jpwolfe31/14x63-Luminator-Flip-Dot-Display/Photos/glued dot pylon too.jpg

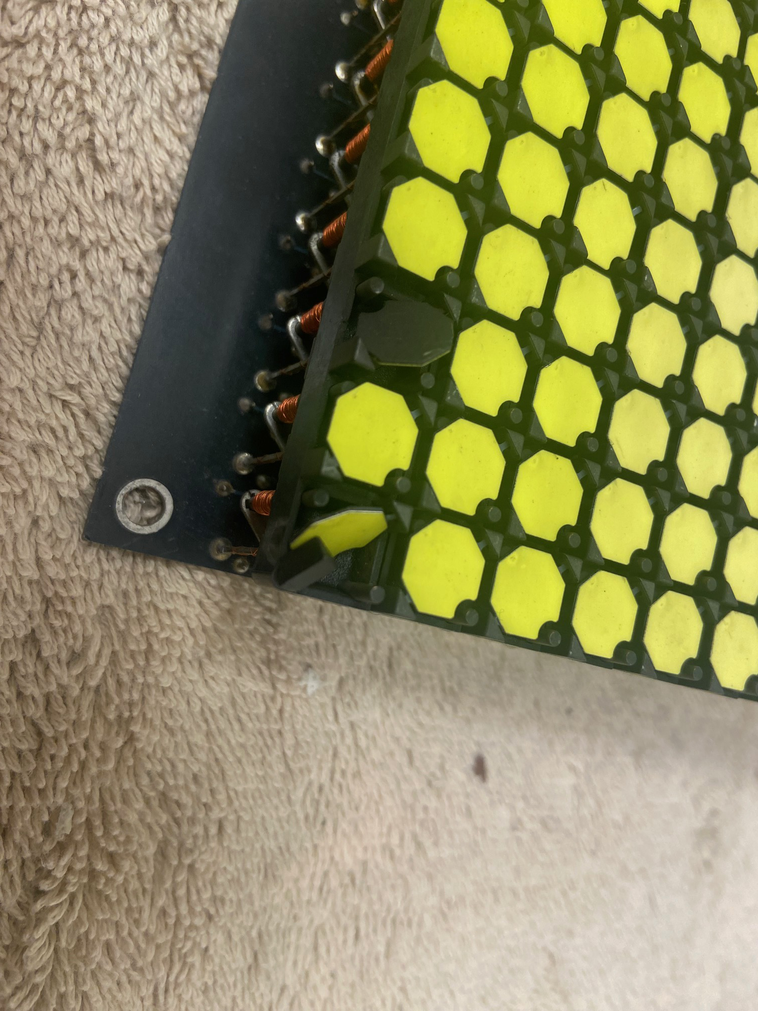
Photos/glued dot pylon too.jpg
