jpwolfe31/14x63-Luminator-Flip-Dot-Display/Photos/almost out of wire.jpg

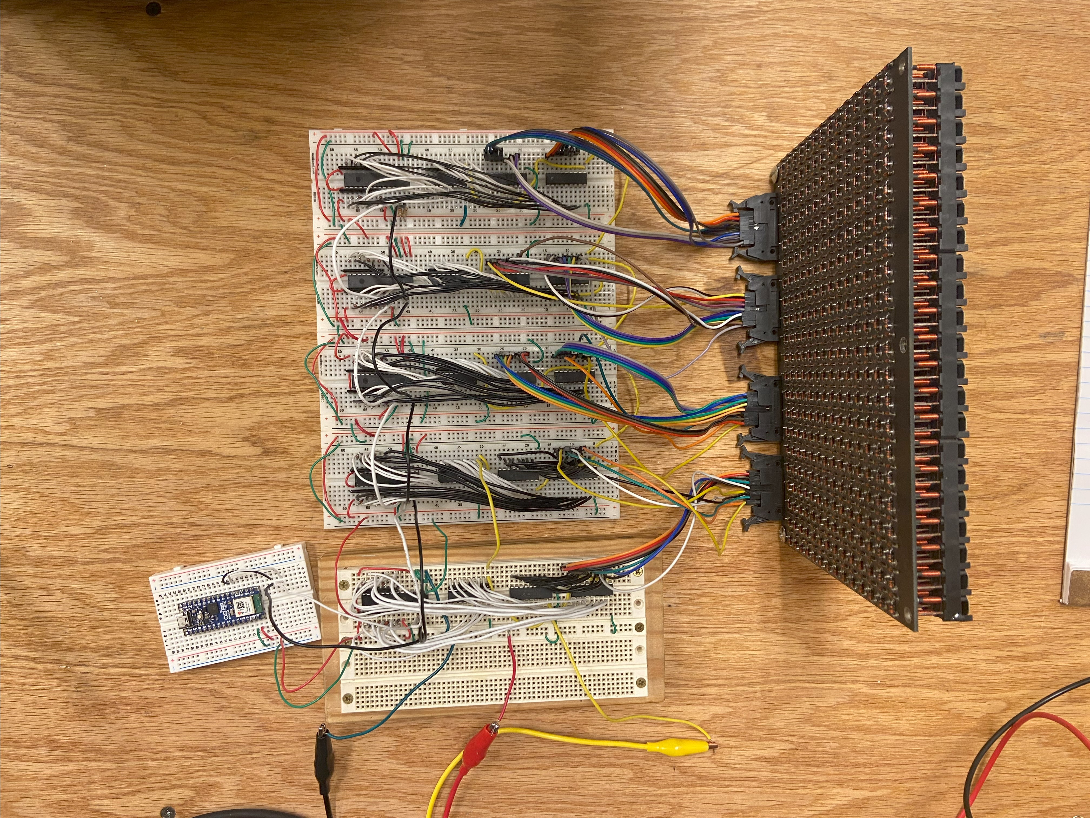
Photos/almost out of wire.jpg
