jpwolfe31/14x63-Luminator-Flip-Dot-Display/IMG_2127.JPG

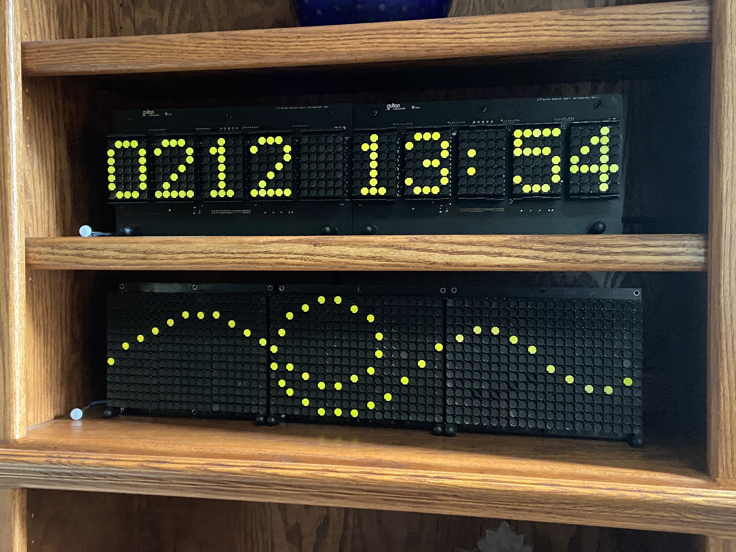
IMG_2127.JPG
