jpwolfe31/14x63-Luminator-Flip-Dot-Display/Photos/as delivered.jpg

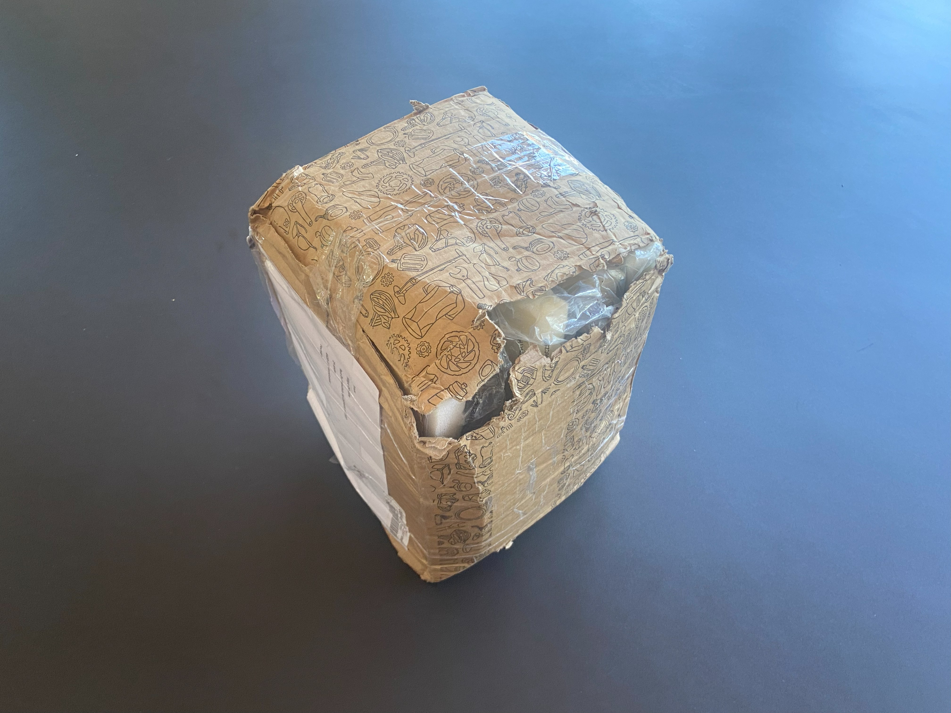
Photos/as delivered.jpg
