jpwolfe31/14x63-Luminator-Flip-Dot-Display/Photos/easily glued back.jpg

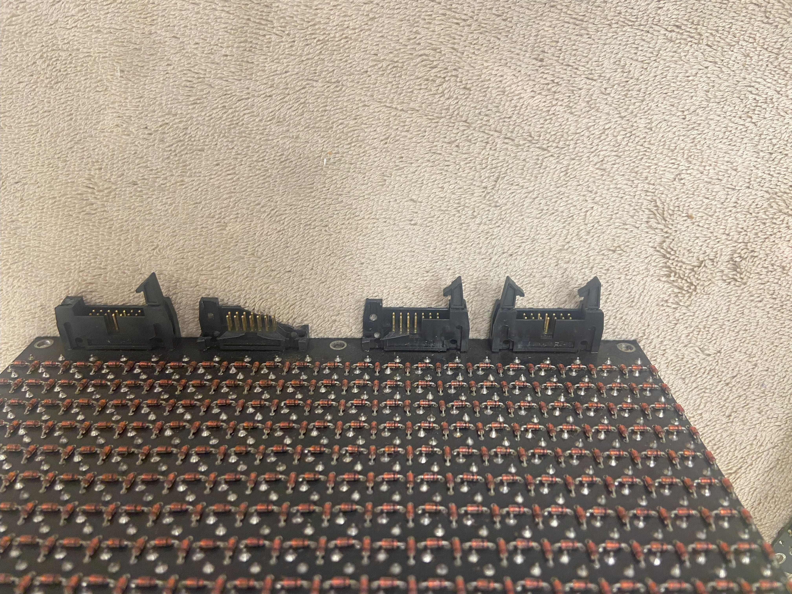
Photos/easily glued back.jpg
