jpwolfe31/14x63-Luminator-Flip-Dot-Display/14-63 Flip Dot PDF Schematic 2-12-25.pdf

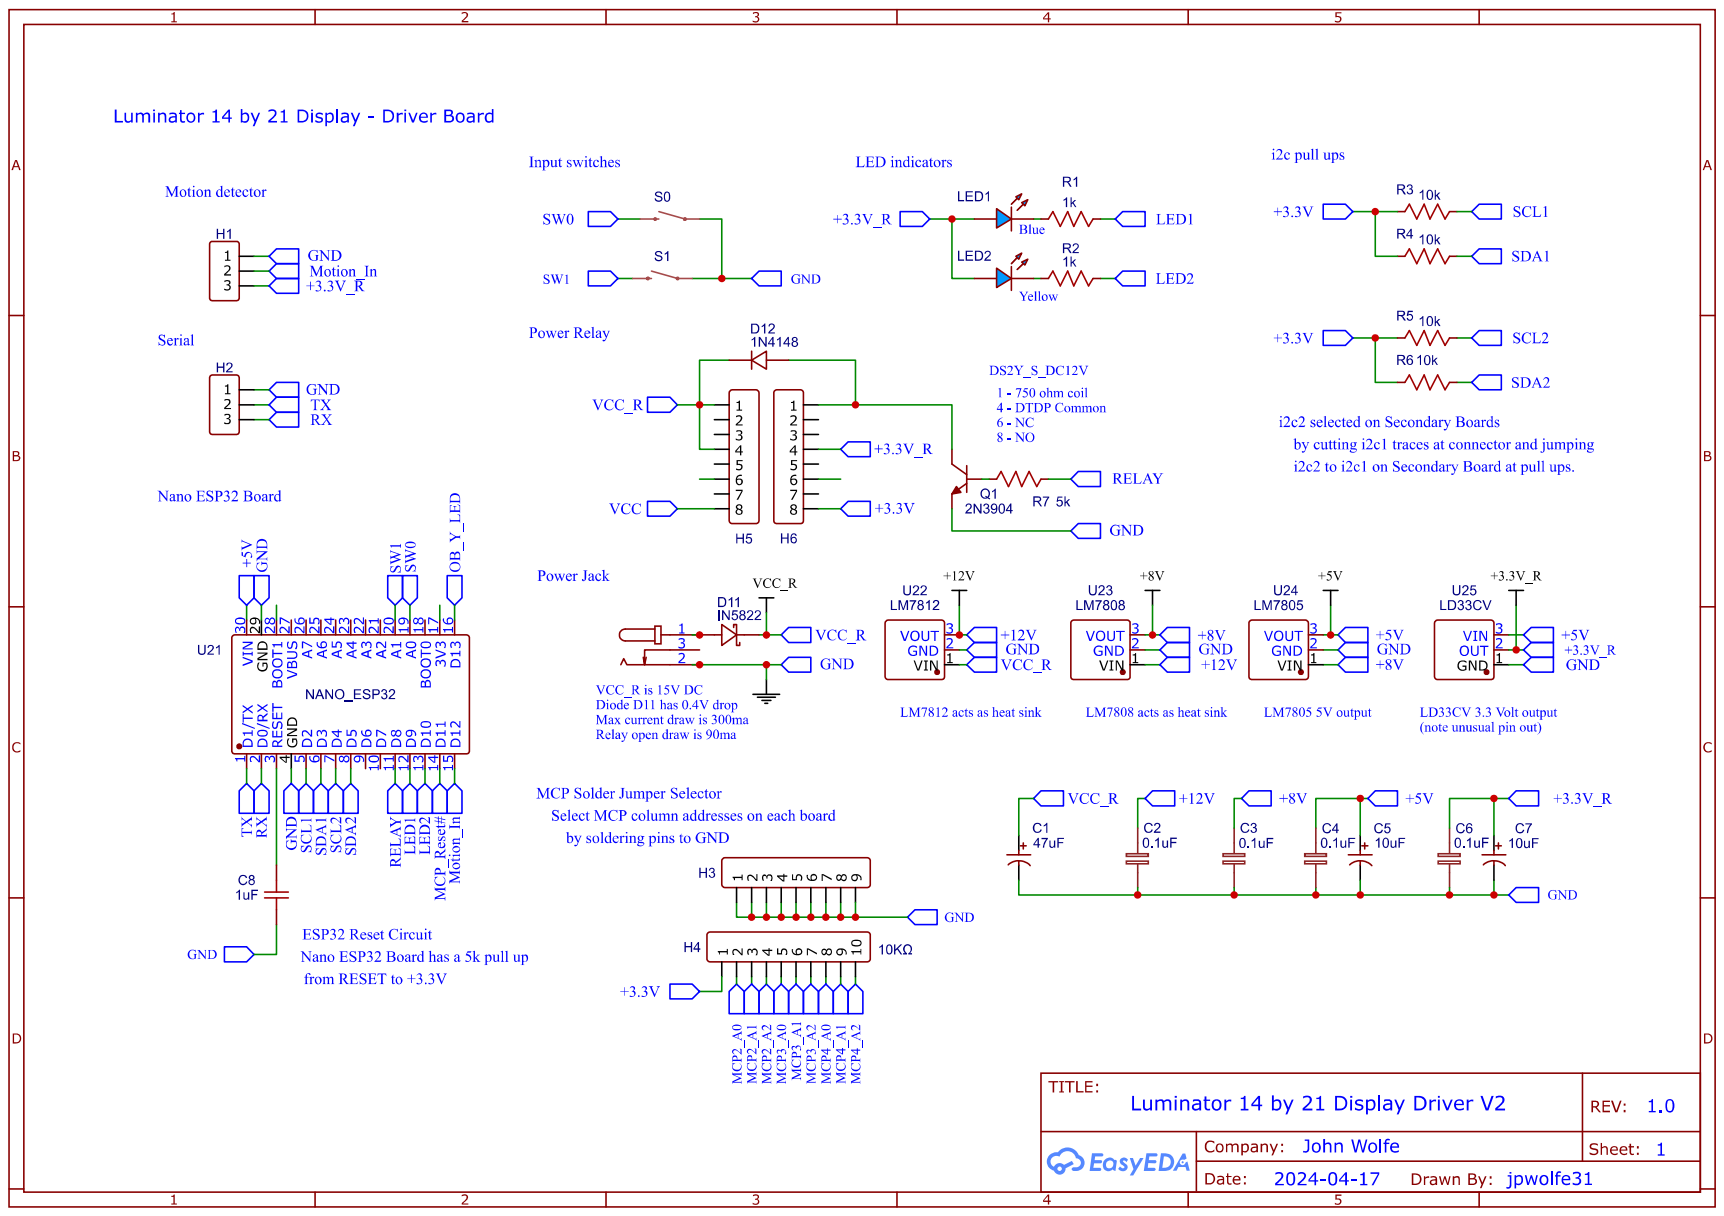
[picture p15: page 1]

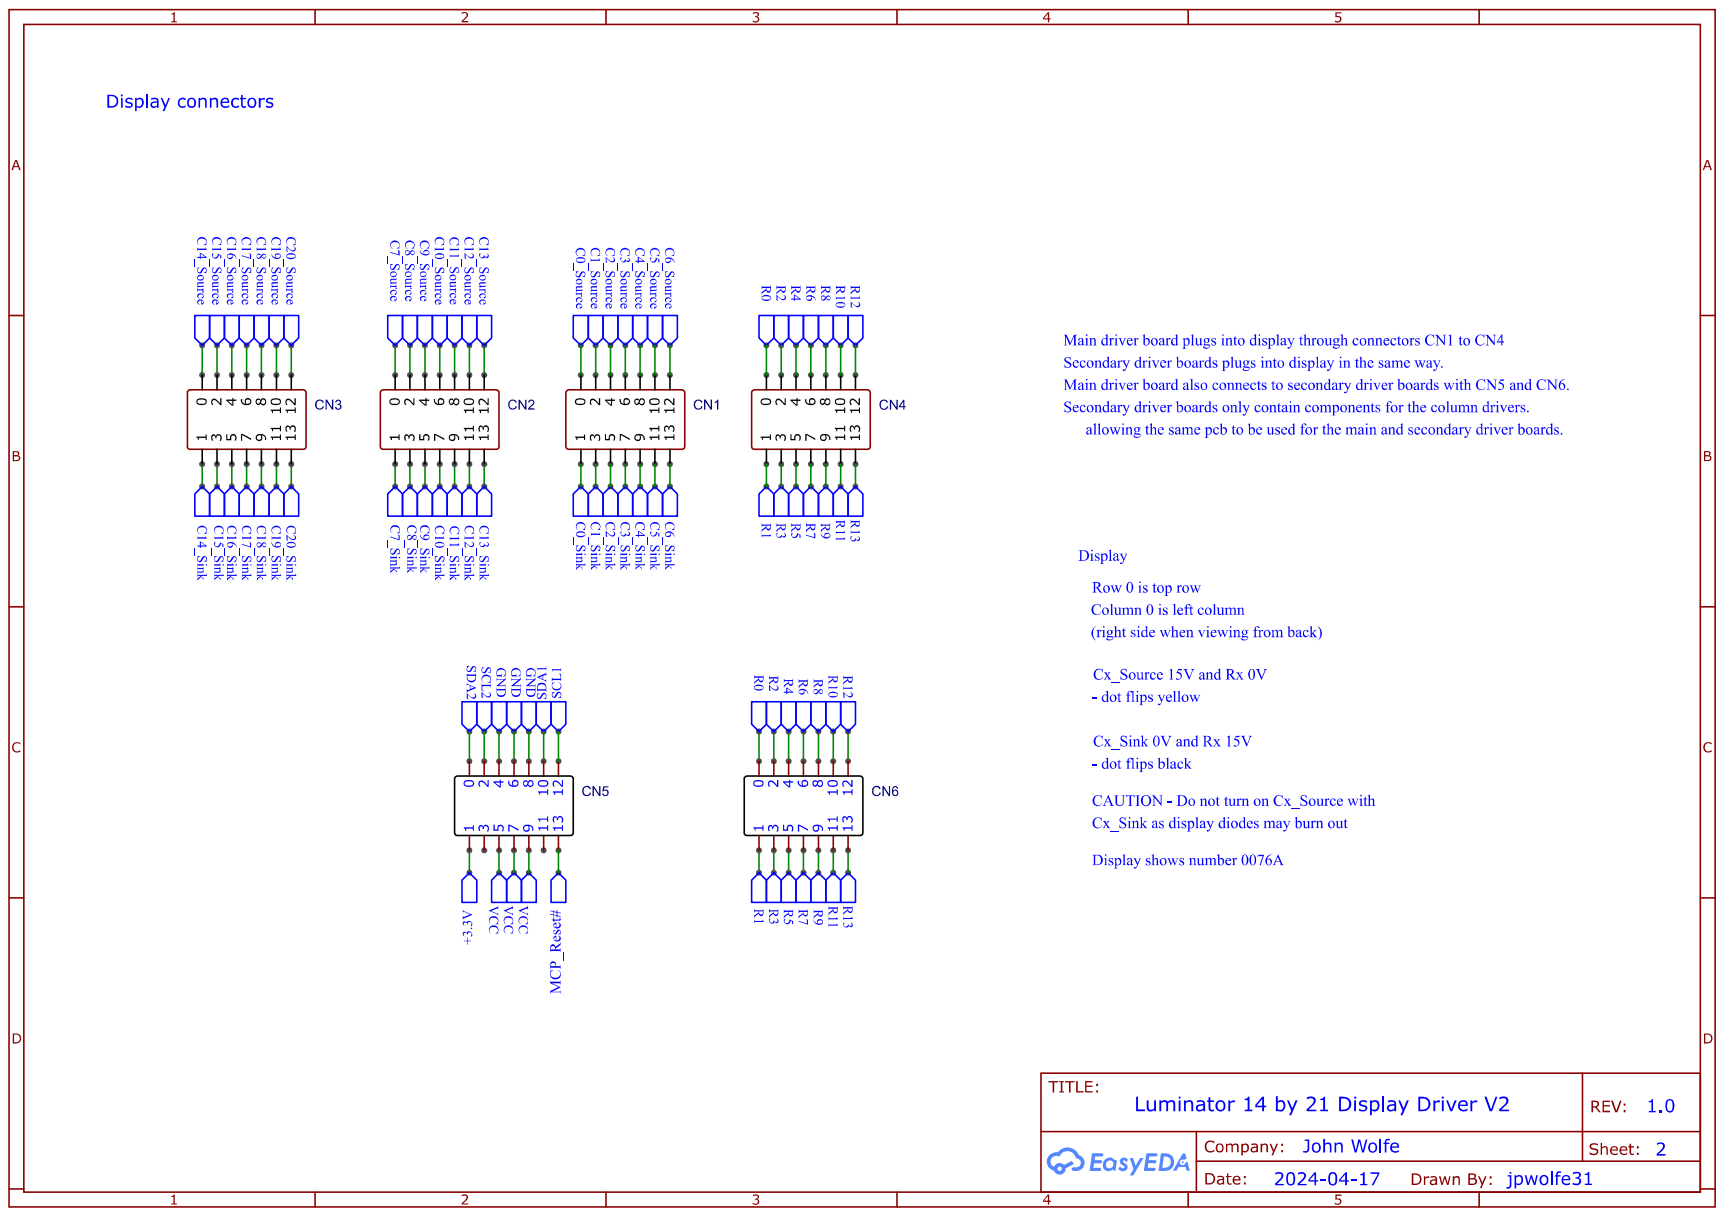
[picture p16: page 2]

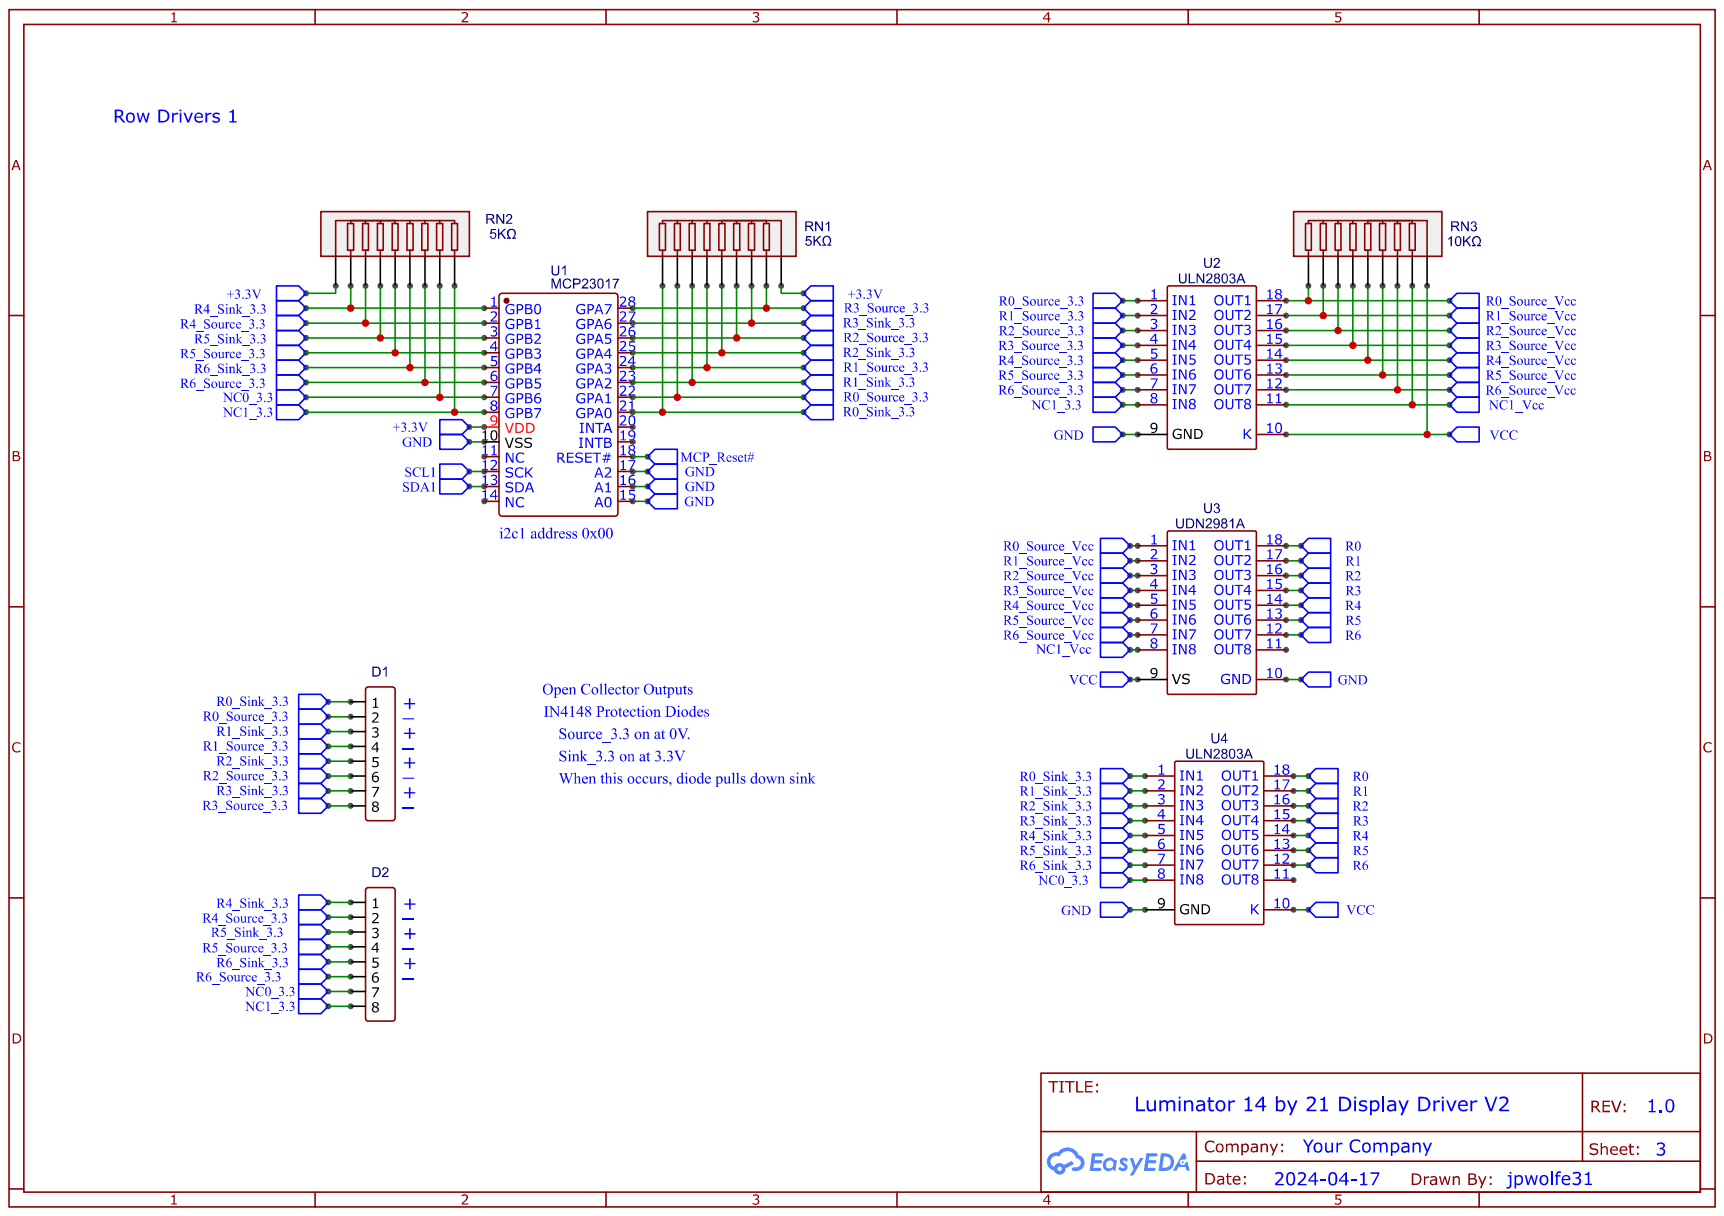
[picture p17: page 3]

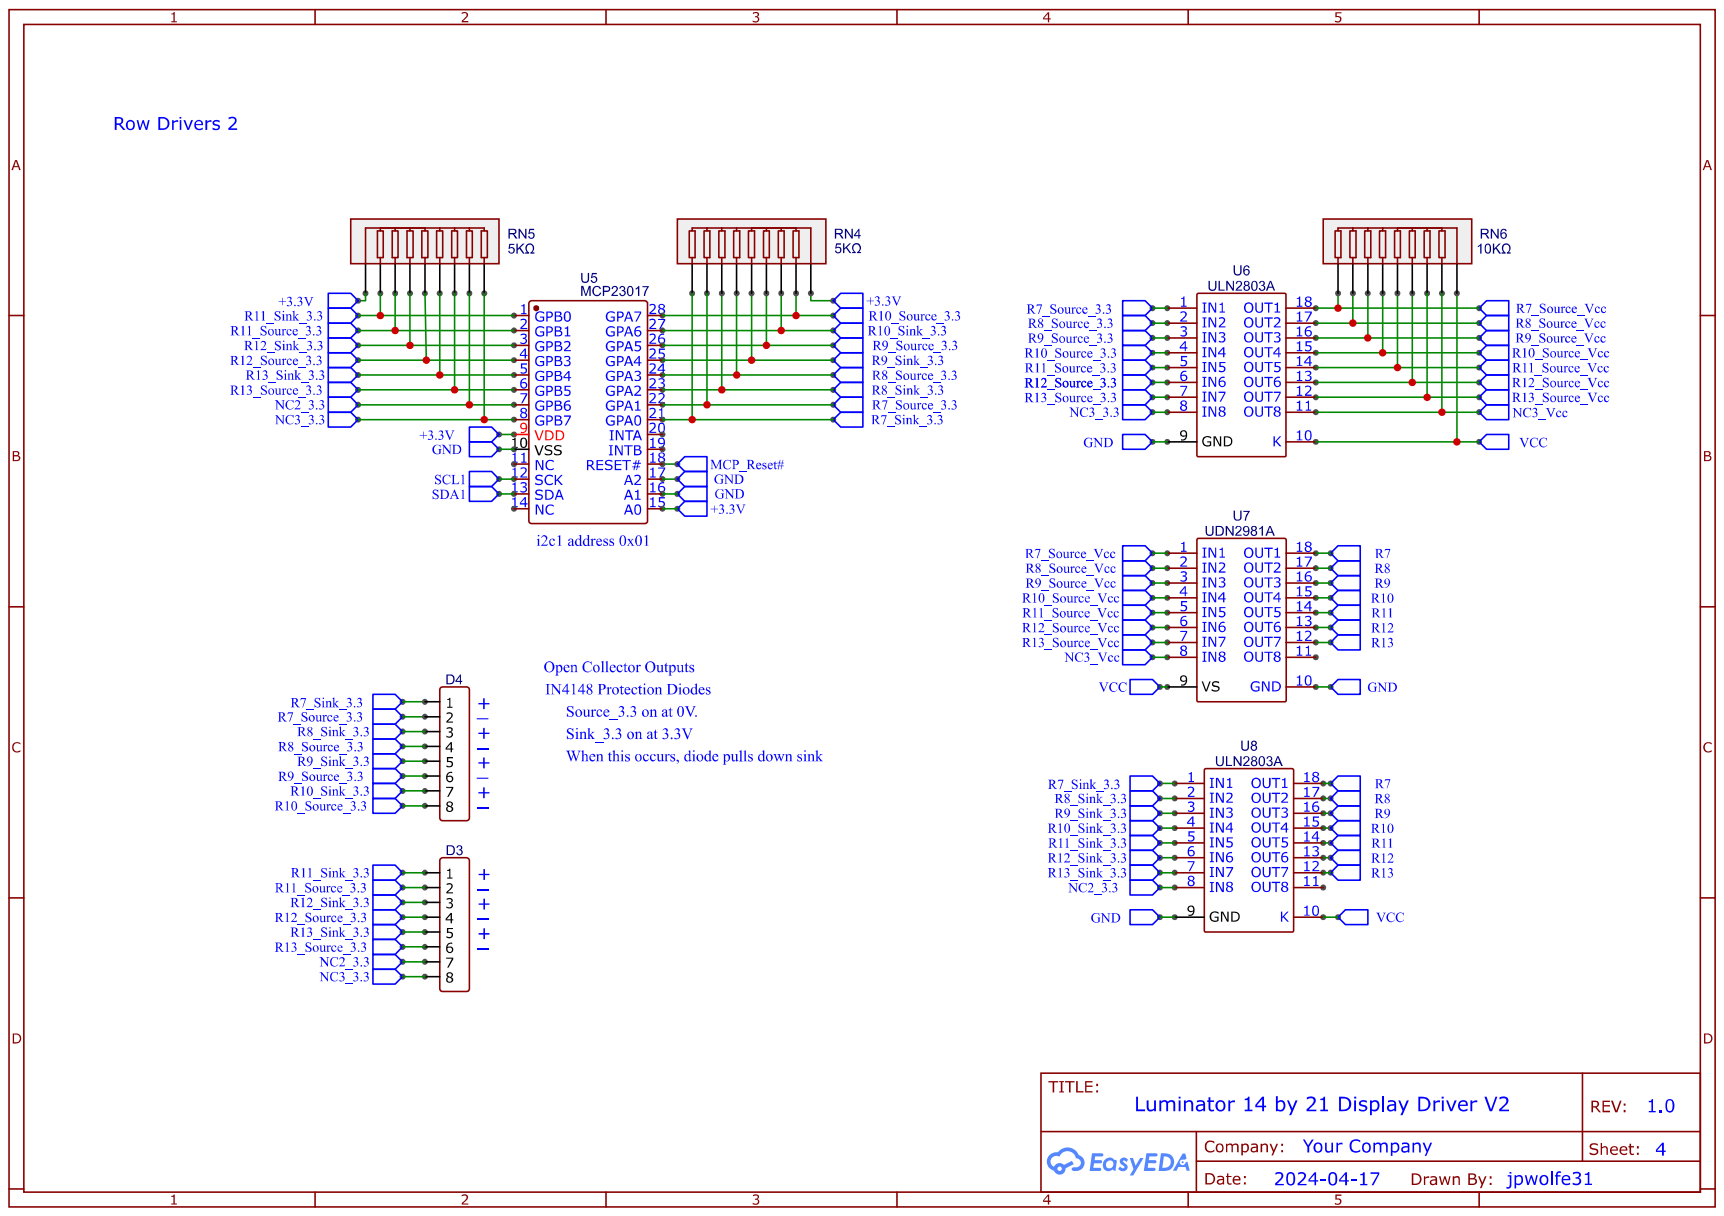
[picture p18: page 4]

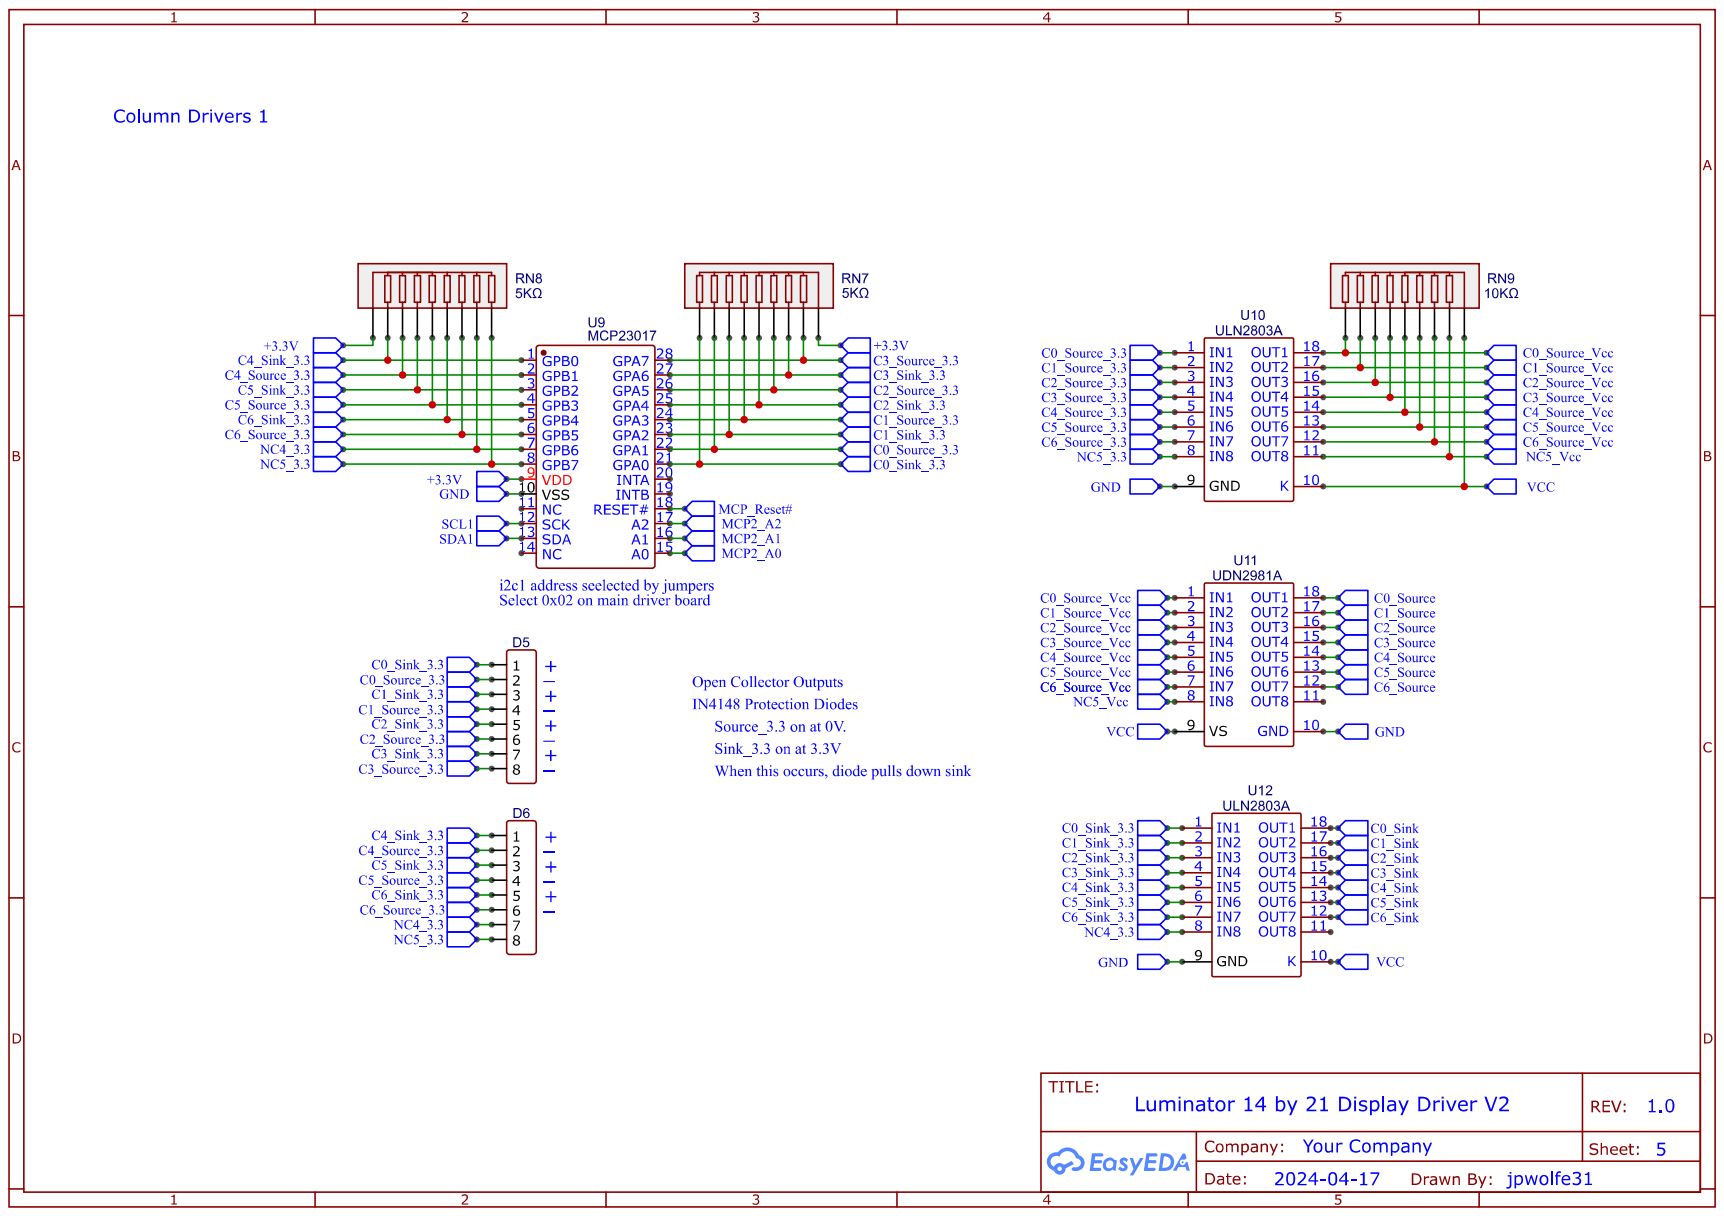
[picture p19: page 5]

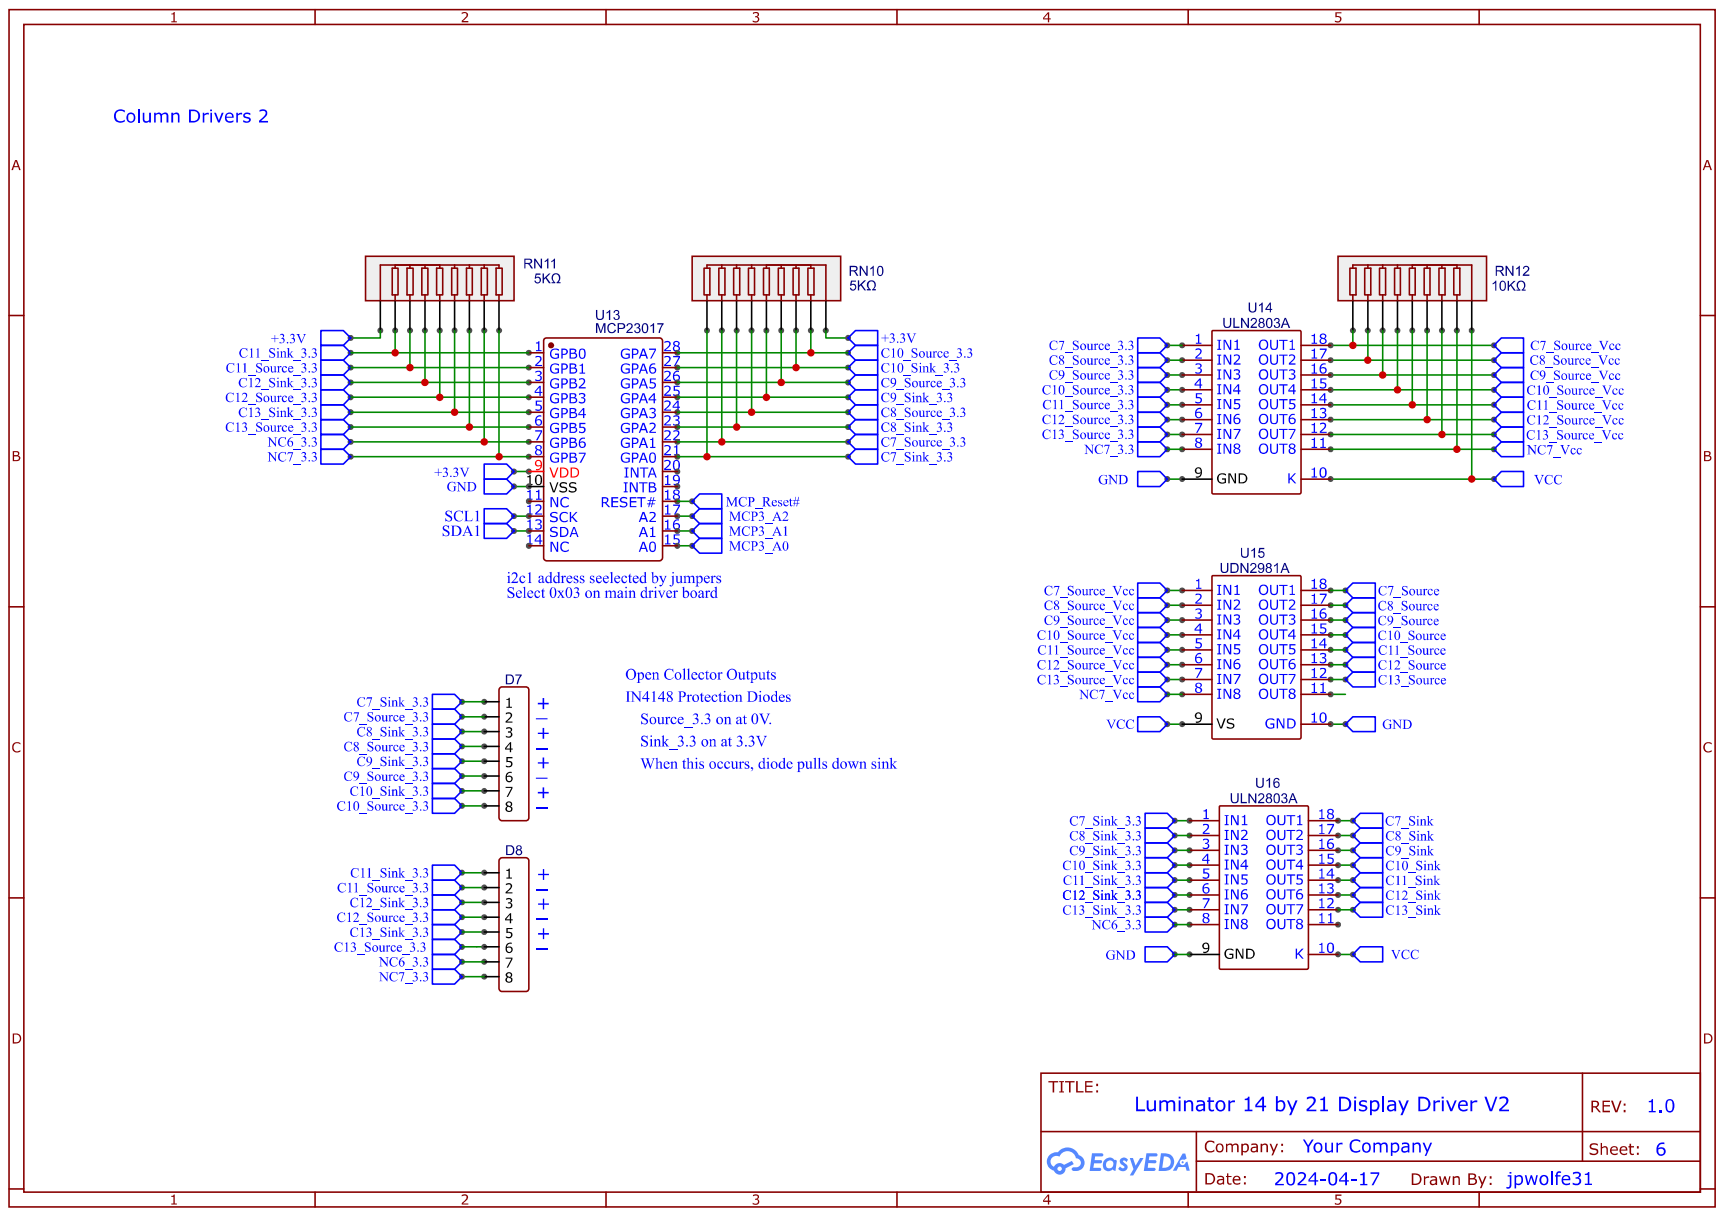
[picture p20: page 6]

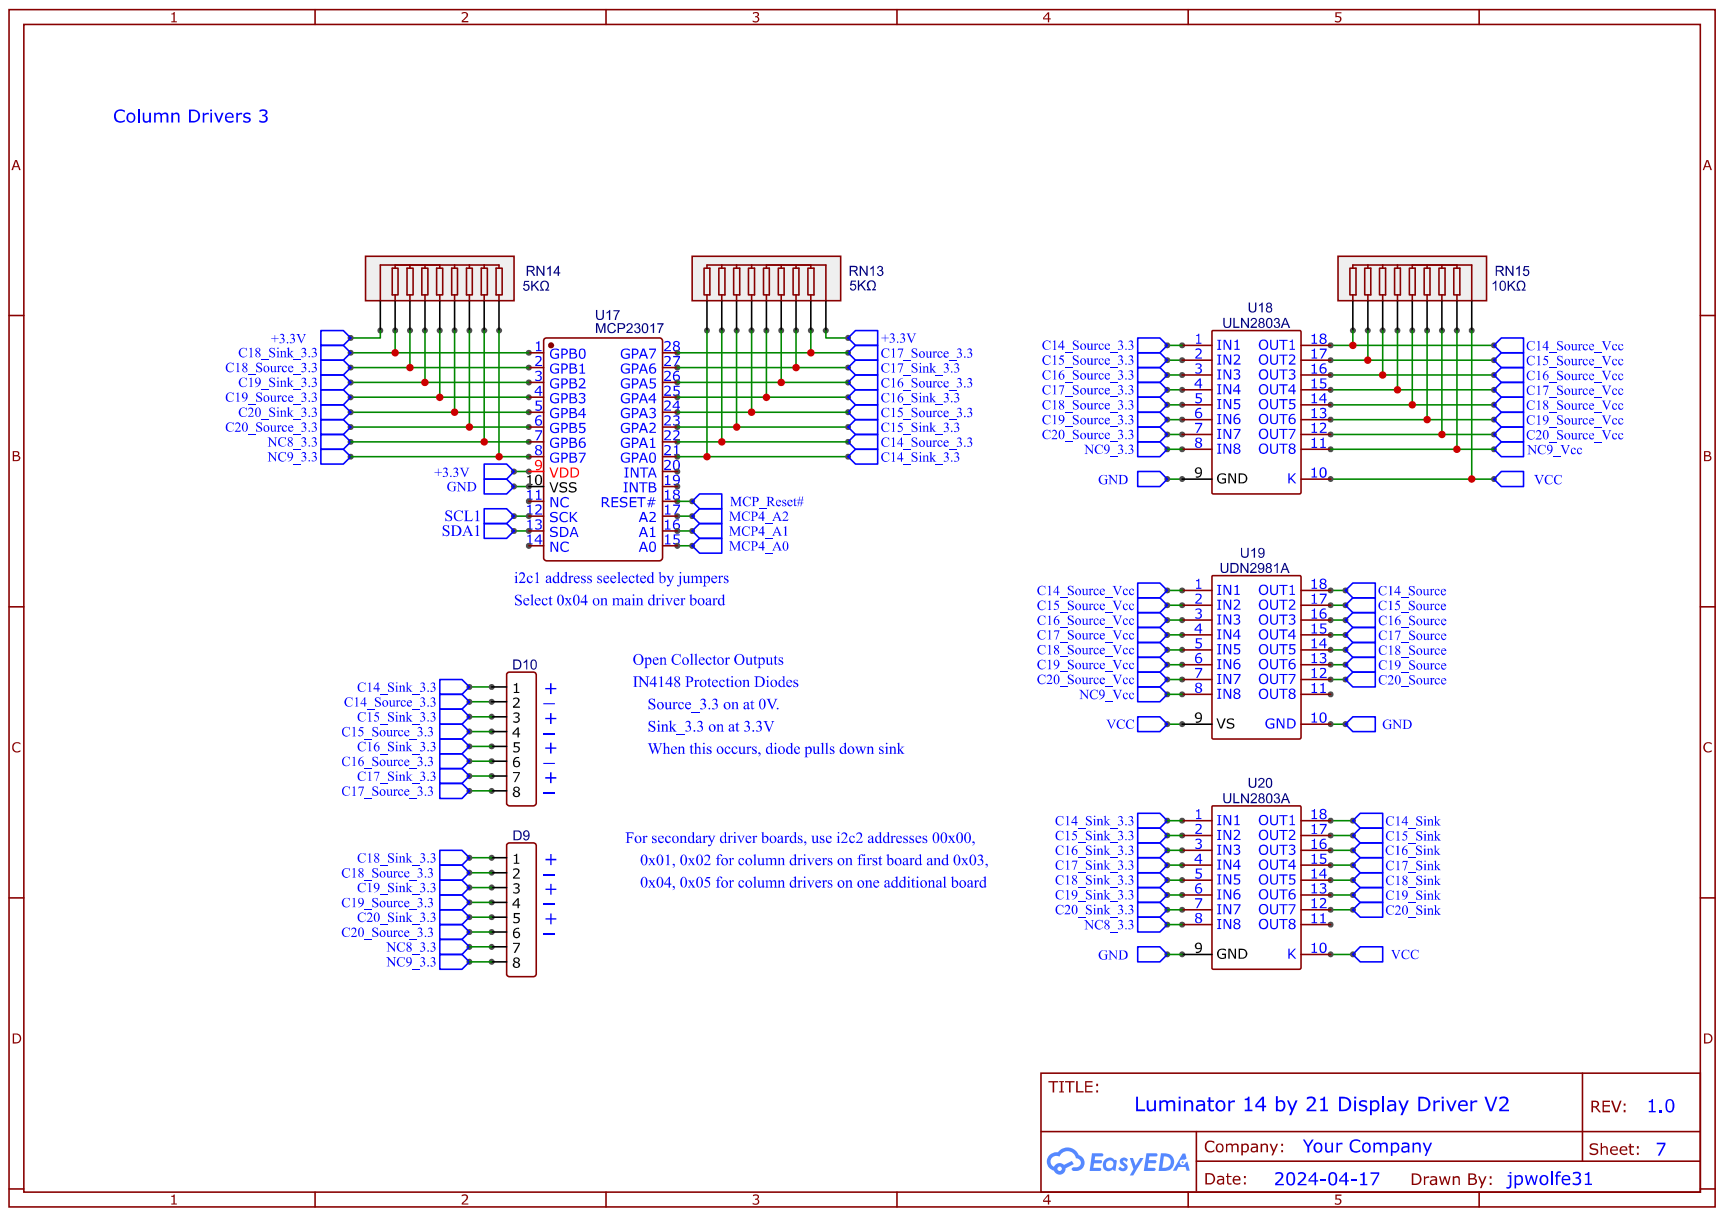
[picture p21: page 7]
