jpwolfe31/14x63-Luminator-Flip-Dot-Display/flip_dot_14x63_2_11_25_uploaded/fonts11x6.ino

// ascii code
// control characters 0-31 plus 127
// printable characters 32-126
const static byte font_data_11x6[] = {
  0b010101,
  0b101010,
  0b010101,
  0b101010,
  0b010101,
  0b101010,
  0b010101,
  0b101010,
  0b010101,
  0b101010,
  0b010101,
  // 0x00 (checker 0) (was ascii nul)
  0b101010,
  0b010101,
  0b101010,
  0b010101,
  0b101010,
  0b010101,
  0b101010,
  0b010101,
  0b101010,
  0b010101,
  0b101010,
  // 0x01 (checker 1) (was ascii soh)
  0b000000,
  0b000000,
  0b000000,
  0b000000,
  0b001000,
  0b000000,
  0b001000,
  0b000000,
  0b000000,
  0b000000,
  0b000000,
  // 0x02 (time left :) (was ascii stx)
  0b000000,
  0b000000,
  0b000000,
  0b000000,
  0b000100,
  0b000000,
  0b000100,
  0b000000,
  0b000000,
  0b000000,
  0b000000,
  // 0x03 (time right :) (was ascii etx)
  0x00, 0x00, 0x00, 0x00, 0x00, 0x00, 0x00, 0x00, 0x00, 0x00, 0x04, // 0x04 // placeholders - as not used
  0x00, 0x00, 0x00, 0x00, 0x00, 0x00, 0x00, 0x00, 0x00, 0x00, 0x05, // 0x05 
  0x00, 0x00, 0x00, 0x00, 0x00, 0x00, 0x00, 0x00, 0x00, 0x00, 0x06, // 0x06 
  0x00, 0x00, 0x00, 0x00, 0x00, 0x00, 0x00, 0x00, 0x00, 0x00, 0x07, // 0x07 
  0x00, 0x00, 0x00, 0x00, 0x00, 0x00, 0x00, 0x00, 0x00, 0x00, 0x08, // 0x08 
  0x00, 0x00, 0x00, 0x00, 0x00, 0x00, 0x00, 0x00, 0x00, 0x00, 0x09, // 0x09 
  0x00, 0x00, 0x00, 0x00, 0x00, 0x00, 0x00, 0x00, 0x00, 0x00, 0x0A, // 0x0A 
  0x00, 0x00, 0x00, 0x00, 0x00, 0x00, 0x00, 0x00, 0x00, 0x00, 0x0B, // 0x0B 
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
  for (int r = 0; r <= 10; r++){
    // (5-c) to feed in other direction from 7x5 font
    for (int c = 0; c <=5; c++){ 
      fd_array_11x6[c][r] = ((font_data_11x6[(char_base_addr * 11) + r]) >> (5-c)) & 0x01; //bitwise and
      }  
  }
}
