jpwolfe31/14x63-Luminator-Flip-Dot-Display/flip_dot_14x63_2_11_25_uploaded/fonts5x4.ino

// ascii code
// only 0-9 / \ ( ) + = < > * checkers clock tick : " , ' - only 
const static byte font_data_5x4[] = {
  0b1010,
  0b0101,
  0b1010,
  0b0101,
  0b1010,
  // 0x00 (checker 0) (was ascii nul)
  0b0101,
  0b1010,
  0b0101,
  0b1010,
  0b0101,
  // 0x01 (checker 1) (was ascii soh)
  0b0000,
  0b0100,
  0b0000,
  0b0100,
  0b0000,
  // 0x02 (time left :) (was ascii stx)
  0b0000,
  0b0010,
  0b0000,
  0b0010,
  0b0000,
  // 0x03 (time right :) (was ascii etx)
  0x00, 0x00, 0x00, 0x00, 0x00, // 0x04 // placeholders - as not used
  0x00, 0x00, 0x00, 0x00, 0x00, // 0x05 
  0x00, 0x00, 0x00, 0x00, 0x00, // 0x06 
  0x00, 0x00, 0x00, 0x00, 0x00, // 0x07 
  0x00, 0x00, 0x00, 0x00, 0x00, // 0x08 
  0x00, 0x00, 0x00, 0x00, 0x00, // 0x09 
  0x00, 0x00, 0x00, 0x00, 0x00, // 0x0A 
  0x00, 0x00, 0x00, 0x00, 0x00, // 0x0B 
  0x00, 0x00, 0x00, 0x00, 0x00, // 0x0C 
  0x00, 0x00, 0x00, 0x00, 0x00, // 0x0D 
  0x00, 0x00, 0x00, 0x00, 0x00, // 0x0E 
  0x00, 0x00, 0x00, 0x00, 0x00, // 0x0F 
  0x00, 0x00, 0x00, 0x00, 0x00, // 0x10 
  0x00, 0x00, 0x00, 0x00, 0x00, // 0x11 
  0x00, 0x00, 0x00, 0x00, 0x00, // 0x12 
  0x00, 0x00, 0x00, 0x00, 0x00, // 0x13 
  0x00, 0x00, 0x00, 0x00, 0x00, // 0x14 
  0x00, 0x00, 0x00, 0x00, 0x00, // 0x15
  0x00, 0x00, 0x00, 0x00, 0x00, // 0x16 
  0x00, 0x00, 0x00, 0x00, 0x00, // 0x17 
  0x00, 0x00, 0x00, 0x00, 0x00, // 0x18 
  0x00, 0x00, 0x00, 0x00, 0x00, // 0x19 
  0x00, 0x00, 0x00, 0x00, 0x00, // 0x1A 
  0x00, 0x00, 0x00, 0x00, 0x00, // 0x1B 
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
  0b11111,
  // 0x40, 0x40, 0x40, 0x40, 0x40,  // 0x5F _
  0x00, 0x00, 0x00, 0x00, 0x00 // 0x60 ` (grave accent) // - placeholder - not used
  // not included lower case letters
  // 0x7F (127) would be ascii DEL (delete)
  // 0s80 (128) to 0xFF (255) are extended ascii used in 1981 IBM PC.
  };

void get_char_fd_array_5x4(char char_out)
{
byte char_base_addr;
char_base_addr = byte(char_out);
//columns first, then rows unlike 7x5 font - 7x5 and 5x4 fonts presented differently
  for (int r = 0; r <= 4; r++){
    // (3-c) to feed in other direction from 7x5 font
    for (int c = 0; c <=3; c++){ 
      fd_array_5x4[c][r] = ((font_data_5x4[(char_base_addr * 5) + r]) >> (3-c)) & 0x01; //bitwise and
      }  
  }
}

void displayCharacter_5x4(int charNum, char charOut)
{
// for 5x4 font
int dotInput;
get_char_fd_array_5x4(charOut); // populates fd_array 5x4 with charOut
// display font
for (int columnInput = 0; columnInput <= 3; columnInput++){ // font is 5 by 4
  for (int rowInput = 0; rowInput <= 4; rowInput++){
    dotInput = fd_array_5x4[columnInput][rowInput]; // get dot value
    // 1 space between chars.  Also start at column 2 and row 5
    setCell(columnInput + 2 + (charNum * (4+1)), (rowInput + 5), dotInput); // adjust columns by charNum
    }  
  }
return;
}

void displayCharacter_5x4s(int charNum, char charOut, int columnStart)
{
// for 5x4 font sideways (up to 3 characters on a 14 row high display)
int dotInput;
get_char_fd_array_5x4(charOut); // populates fd_array 5x4 with charOut
// display font
// start at row 13 (column 13) and go up display after 3 char to row 0 (column 0)
for (int columnInput = 13; columnInput >= 10; columnInput--){ // font is 5 by 4
  for (int rowInput = 0; rowInput <= 4; rowInput++){
    dotInput = fd_array_5x4[13 - columnInput][rowInput]; // get dot value
    // 1 space between chars.  columnstart is offset from left of display
    //void setCell(int column, int row, int dot) - for ref
    setCell(rowInput + columnStart, columnInput - (charNum * (4+1)), dotInput); // adjust rows by charNum
    }  
  }
return;
}
