jpwolfe31/14x63-Luminator-Flip-Dot-Display/flip_dot_14x63_2_11_25_uploaded/setCell.ino

// setCell function for interfacing with MCP23017 and Display

void setCell(int column, int row, int dot){
// column is column 0-63
// row is row 0-13
// dot is 1 (yellow), 0 (black), 2 (off or no change)
// column first as row can drive more than one dot
//   and display moves left to right
// Cx_Source 12V and Rx 0v - dot flips yellow
// Cx_Sink 0V and Rx 12V - dot flips black
// Off is no output to column or row
// Cx controls pulse length of 500us

switch (column) {
  case 0:  // do something when var equals 0, etc to 63
    if (dot == 1){col0y();} // turn on source
    if (dot == 0){col0b();} // turn on sink
    if (dot == 2){col0o();} // turn off source and sink
    break;
  case 1:
    if (dot == 1){col1y();} // turn on source
    if (dot == 0){col1b();} // turn on sink
    if (dot == 2){col1o();} // turn off source and sink
    break;
  case 2:
    if (dot == 1){col2y();} // turn on source
    if (dot == 0){col2b();} // turn on sink
    if (dot == 2){col2o();} // turn off source and sink
    break;
  case 3:
    if (dot == 1){col3y();} // turn on source
    if (dot == 0){col3b();} // turn on sink
    if (dot == 2){col3o();} // turn off source and sink
    break;
  case 4:
    if (dot == 1){col4y();} // turn on source
    if (dot == 0){col4b();} // turn on sink
    if (dot == 2){col4o();} // turn off source and sink
    break;
  case 5:
    if (dot == 1){col5y();} // turn on source
    if (dot == 0){col5b();} // turn on sink
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
i2c1.write(0x01); // IODIRB is 0x01 in Bank0
i2c1.write(0b10100010); //  turn on row source (active low) and off sink (active high)
i2c1.endTransmission(); //ends communication with slave device
}
void row12o(){ // turn off row source and sink
// Cx_Sink 0V and Rx 12V - dot flips black
// Cx_Source 12V and Rx 0v - dot flips yellow
i2c1.beginTransmission(0x21); //starts talking to slave device
i2c1.write(0x01); // IODIRB is 0x01 in Bank0
i2c1.write(0b10101010); //  turn off row source (active low) and sink ( active high)
i2c1.endTransmission(); //ends communication with slave device
}
void row13y(){ // turn on row sink
// Cx_Sink 0V and Rx 12V - dot flips black
// Cx_Source 12V and Rx 0v - dot flips yellow
i2c1.beginTransmission(0x21); //starts talking to slave device
i2c1.write(0x01); // IODIRB is 0x01 in Bank0
i2c1.write(0b10111010); //  turn off row source (active low) and on sink ( active high)
i2c1.endTransmission(); //ends communication with slave device
}
void row13b() { // turn on row source
// Cx_Sink 0V and Rx 12V - dot flips black
// Cx_Source 12V and Rx 0v - dot flips yellow
i2c1.beginTransmission(0x21); //starts talking to slave device
i2c1.write(0x01); // IODIRB is 0x01 in Bank0
i2c1.write(0b10001010); //  turn on row source (active low) and off sink (active high)
i2c1.endTransmission(); //ends communication with slave device
}
void row13o(){ // turn off row source and sink
// Cx_Sink 0V and Rx 12V - dot flips black
// Cx_Source 12V and Rx 0v - dot flips yellow
i2c1.beginTransmission(0x21); //starts talking to slave device
i2c1.write(0x01); // IODIRB is 0x01 in Bank0
i2c1.write(0b10101010); //  turn off row source (active low) and sink ( active high)
i2c1.endTransmission(); //ends communication with slave device
}

void col0y(){ // turn on column source
// Cx_Sink 0V and Rx 12V - dot flips black
// Cx_Source 12V and Rx 0v - dot flips yellow
i2c1.beginTransmission(0x22); //starts talking to slave device
i2c1.write(0x00); // IODIRA is 0x00 in Bank0
i2c1.write(0b10101000); //  turn on column source (active low) and off sink ( active high)
i2c1.endTransmission(); //ends communication with slave device
}
void col0b() { // turn on column sink
// Cx_Sink 0V and Rx 12V - dot flips black
// Cx_Source 12V and Rx 0v - dot flips yellow
i2c1.beginTransmission(0x22); //starts talking to slave device
i2c1.write(0x00); // IODIRA is 0x00 in Bank0
i2c1.write(0b10101011); //  turn off column source (active low) and on sink ( active high)
i2c1.endTransmission(); //ends communication with slave device
}
void col0o(){ // turn off column source and sink
// Cx_Sink 0V and Rx 12V - dot flips black
// Cx_Source 12V and Rx 0v - dot flips yellow
i2c1.beginTransmission(0x22); //starts talking to slave device
i2c1.write(0x00); // IODIRA is 0x00 in Bank0
i2c1.write(0b10101010); //  turn off column source (active low) and sink ( active high)
i2c1.endTransmission(); //ends communication with slave device
}
void col1y(){ // turn on column source
// Cx_Sink 0V and Rx 12V - dot flips black
// Cx_Source 12V and Rx 0v - dot flips yellow
i2c1.beginTransmission(0x22); //starts talking to slave device
i2c1.write(0x00); // IODIRA is 0x00 in Bank0
i2c1.write(0b10100010); //  turn on column source (active low) and off sink ( active high)
i2c1.endTransmission(); //ends communication with slave device
}
void col1b() { // turn on column sink
// Cx_Sink 0V and Rx 12V - dot flips black
// Cx_Source 12V and Rx 0v - dot flips yellow
i2c1.beginTransmission(0x22); //starts talking to slave device
i2c1.write(0x00); // IODIRA is 0x00 in Bank0
i2c1.write(0b10101110); //  turn off column source (active low) and on sink ( active high)
i2c1.endTransmission(); //ends communication with slave device
}
void col1o(){ // turn off column source and sink
// Cx_Sink 0V and Rx 12V - dot flips black
// Cx_Source 12V and Rx 0v - dot flips yellow
i2c1.beginTransmission(0x22); //starts talking to slave device
i2c1.write(0x00); // IODIRA is 0x00 in Bank0
i2c1.write(0b10101010); //  turn off column source (active low) and sink ( active high)
i2c1.endTransmission(); //ends communication with slave device
}
void col2y(){ // turn on column source
// Cx_Sink 0V and Rx 12V - dot flips black
// Cx_Source 12V and Rx 0v - dot flips yellow
i2c1.beginTransmission(0x22); //starts talking to slave device
i2c1.write(0x00); // IODIRA is 0x00 in Bank0
i2c1.write(0b10001010); //  turn on source (active low) and off sink ( active high)
i2c1.endTransmission(); //ends communication with slave device
}
void col2b() { // turn on column sink
// Cx_Sink 0V and Rx 12V - dot flips black
// Cx_Source 12V and Rx 0v - dot flips yellow
i2c1.beginTransmission(0x22); //starts talking to slave device
i2c1.write(0x00); // IODIRA is 0x00 in Bank0
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
i2c2.write(0x01); // IODIRB is 0x01 in Bank0
i2c2.write(0b10101010); //  turn off column source (active low) and sink ( active high)
i2c2.endTransmission(); //ends communication with slave device
}
void col62y(){ // turn on column source
// Cx_Sink 0V and Rx 12V - dot flips black
// Cx_Source 12V and Rx 0v - dot flips yellow
i2c2.beginTransmission(0x25); //starts talking to slave device
i2c2.write(0x01); // IODIRB is 0x01 in Bank0
i2c2.write(0b10001010); //  turn on source (active low) and off sink ( active high)
i2c2.endTransmission(); //ends communication with slave device
}
void col62b() { // turn on column sink
// Cx_Sink 0V and Rx 12V - dot flips black
// Cx_Source 12V and Rx 0v - dot flips yellow
i2c2.beginTransmission(0x25); //starts talking to slave device
i2c2.write(0x01); // IODIRB is 0x01 in Bank0
i2c2.write(0b10111010); //  turn off source (active low) and on sink ( active high)
i2c2.endTransmission(); //ends communication with slave device
}
void col62o(){ // turn off column source and sink
// Cx_Sink 0V and Rx 12V - dot flips black
// Cx_Source 12V and Rx 0v - dot flips yellow
i2c2.beginTransmission(0x25); //starts talking to slave device
i2c2.write(0x01); // IODIRB is 0x01 in Bank0
i2c2.write(0b10101010); //  turn off source (active low) and sink ( active high)
i2c2.endTransmission(); //ends communication with slave device
}


void mcpConfigure(){
// MCP23017 address b000 on each i2c
// assumes i2c has begun at 400k baud
// MCP address range is 0x20 to 0x27
// this configures 0x20 to 0x24  
// MCP 0x20 is row0-8 and 0x21  is row 8-14  i2c1
// MCP 0x22 is column 0-7, 0x23 is column 8 to 15 and 0x24 is column 16 to 20 i2c1
// **** will need to update mcp addresses of i2c1 to 0-5 for columns on secondary boards

// note - POR default is Bank0 or '0' (16 bit mode)
// note - POR default is SEQOP enabled or '0' 
// need - to set IOCON to Bank0 or '0' (16 bit mode) with no sequental operation use IOCON address 0x0A data 0x20
// note - seq op on is a 0 and off is a 1
// note - with seq op off, address counter toggles between PortA and PortB on subequent writes or reads
// consider adding this to each output port to preconfiure bits for future writes
//   as first write does not operate like later writes
//   i2c1.write(0b10101010); //  turn off column source (active low) and sink (active high)

// mcp 0x00 i2c1 (comments applicable to all below)
i2c1.beginTransmission(0x20);//begins talking to slave device
i2c1.write(0x0A); // selects the IOCON register 0x0A address using Bank0 (16 bit mode) POR default
// changes default to no sequential
i2c1.write(0b00100000); // sets bit 5 to 1 for no seq operation mode 
i2c1.endTransmission(); //ends communication with slave device
delay(50);
// set BANK0 I/O PORTA latch to 0x00   OLATA 0x14 set 0x00
i2c1.beginTransmission(0x20);// begins talking again to slave device
i2c1.write(0x14); // selects the OLATA register address 14 in Bank0 mode
i2c1.write(0x00); // sets all bits to 0
i2c1.endTransmission(); // ends communication with slave device
delay(50);
// set BANK0 I/O PORTA input pins to have 100k pull-ups  GPPUA 0x0C set 0xff
i2c1.beginTransmission(0x20);
i2c1.write(0x0C); // selects the pull-up GPPUA register
i2c1.write(0xff); // 1 sets inputs with 100k pull-ups 
i2c1.endTransmission();
delay(50);
// set BANK0 I/O PORTB latch to 0x00   OLATB 0x15 set 0x00
i2c1.beginTransmission(0x20);// begins talking again to slave device
i2c1.write(0x15); // selects the OLATB register address 1A in Bank0 mode
i2c1.write(0x00); // sets all bits to 0
i2c1.endTransmission(); // ends communication with slave device
delay(50);
// set BANK0 I/O PORTB input pins to have 100k pull-ups  GPPUB 0x0D set 0xff
i2c1.beginTransmission(0x20);
i2c1.write(0x0D); // selects the pull-up GPPUB register
i2c1.write(0xff); // 1 sets inputs with 100k pull-ups 
i2c1.endTransmission();
delay(50);

// mcp 0x01  i2c1
i2c1.beginTransmission(0x21);
i2c1.write(0x0A);
i2c1.write(0b00100000);
i2c1.endTransmission();
delay(50);
i2c1.beginTransmission(0x21);
i2c1.write(0x14);
i2c1.write(0x00);
i2c1.endTransmission();
delay(50);
i2c1.beginTransmission(0x21);
i2c1.write(0x0C);
i2c1.write(0xff);
i2c1.endTransmission();
delay(50);
i2c1.beginTransmission(0x21);
i2c1.write(0x15);
i2c1.write(0x00);
i2c1.endTransmission();
delay(50);
i2c1.beginTransmission(0x21);
i2c1.write(0x0D);
i2c1.write(0xff);
i2c1.endTransmission();
delay(50);

// mcp 0x02 i2c1
i2c1.beginTransmission(0x22);
i2c1.write(0x0A);
i2c1.write(0b00100000);
i2c1.endTransmission();
delay(50);
i2c1.beginTransmission(0x22);
i2c1.write(0x14);
i2c1.write(0x00);
i2c1.endTransmission();
delay(50);
i2c1.beginTransmission(0x22);
i2c1.write(0x0C);
i2c1.write(0xff);
i2c1.endTransmission();
delay(50);
i2c1.beginTransmission(0x22);
i2c1.write(0x15);
i2c1.write(0x00);
i2c1.endTransmission();
delay(50);
i2c1.beginTransmission(0x22);
i2c1.write(0x0D);
i2c1.write(0xff);
i2c1.endTransmission();
delay(50);

// mcp 0x03  i2c1
i2c1.beginTransmission(0x23);
i2c1.write(0x0A);
i2c1.write(0b00100000);
i2c1.endTransmission();
delay(50);
i2c1.beginTransmission(0x23);
i2c1.write(0x14);
i2c1.write(0x00);
i2c1.endTransmission();
delay(50);
i2c1.beginTransmission(0x23);
i2c1.write(0x0C);
i2c1.write(0xff);
i2c1.endTransmission();
delay(50);
i2c1.beginTransmission(0x23);
i2c1.write(0x15);
i2c1.write(0x00);
i2c1.endTransmission();
delay(50);
i2c1.beginTransmission(0x23);
i2c1.write(0x0D);
i2c1.write(0xff);
i2c1.endTransmission();
delay(50);

// mcp 0x04  i2c1
i2c1.beginTransmission(0x24);
i2c1.write(0x0A);
i2c1.write(0b00100000);
i2c1.endTransmission();
delay(50);
i2c1.beginTransmission(0x24);
i2c1.write(0x14);
i2c1.write(0x00);
i2c1.endTransmission();
delay(50);
i2c1.beginTransmission(0x24);
i2c1.write(0x0C);
i2c1.write(0xff);
i2c1.endTransmission();
delay(50);
i2c1.beginTransmission(0x24);
i2c1.write(0x15);
i2c1.write(0x00);
i2c1.endTransmission();
delay(50);
i2c1.beginTransmission(0x24);
i2c1.write(0x0D);
i2c1.write(0xff);
i2c1.endTransmission();
delay(50);

// mcp 0x00 i2c2
i2c2.beginTransmission(0x20);
i2c2.write(0x0A);
i2c2.write(0b00100000);
i2c2.endTransmission();
delay(50);
i2c2.beginTransmission(0x20);
i2c2.write(0x14);
i2c2.write(0x00);
i2c2.endTransmission();
delay(50);
i2c2.beginTransmission(0x20);
i2c2.write(0x0C);
i2c2.write(0xff);
i2c2.endTransmission();
delay(50);
i2c2.beginTransmission(0x20);
i2c2.write(0x15);
i2c2.write(0x00);
i2c2.endTransmission();
delay(50);
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
i2c2.write(0x0C);
i2c2.write(0xff);
i2c2.endTransmission();
delay(50);
i2c2.beginTransmission(0x25);
i2c2.write(0x15);
i2c2.write(0x00);
i2c2.endTransmission();
delay(50);
i2c2.beginTransmission(0x25);
i2c2.write(0x0D);
i2c2.write(0xff);
i2c2.endTransmission();
delay(50);
}
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
